kyma-un/srv_delorian/delorian_ws/src/delorian_description/meshes/main_frame.stl

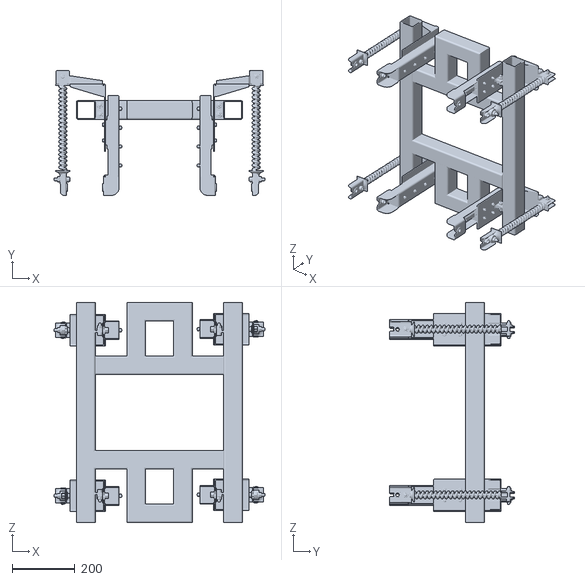
[picture p2: CAD file, 2026-10-21]
delorian_ws/src/delorian_description/meshes/main_frame.stl
670.1 x 396.6 x 700.0
