kyma-un/srv_delorian/delorian_ws/src/delorian_description/meshes/wheel.stl

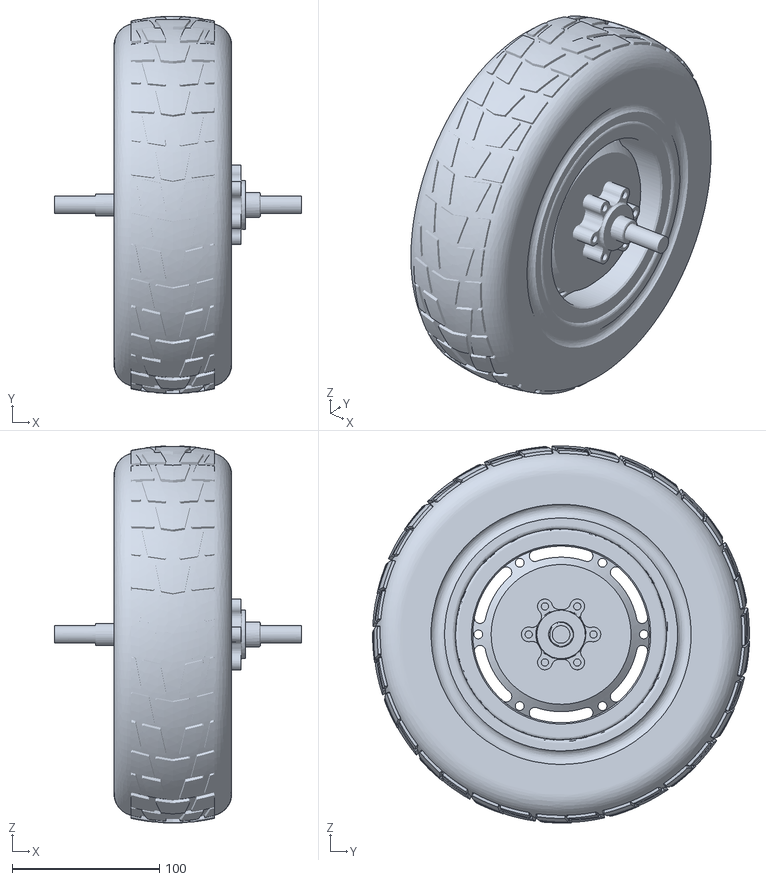
[picture p3: CAD file, 2026-10-21]
delorian_ws/src/delorian_description/meshes/wheel.stl
168.0 x 256.4 x 256.3
