kyma-un/srv_delorian/Diseño_mecanico/Frame_principal.stp

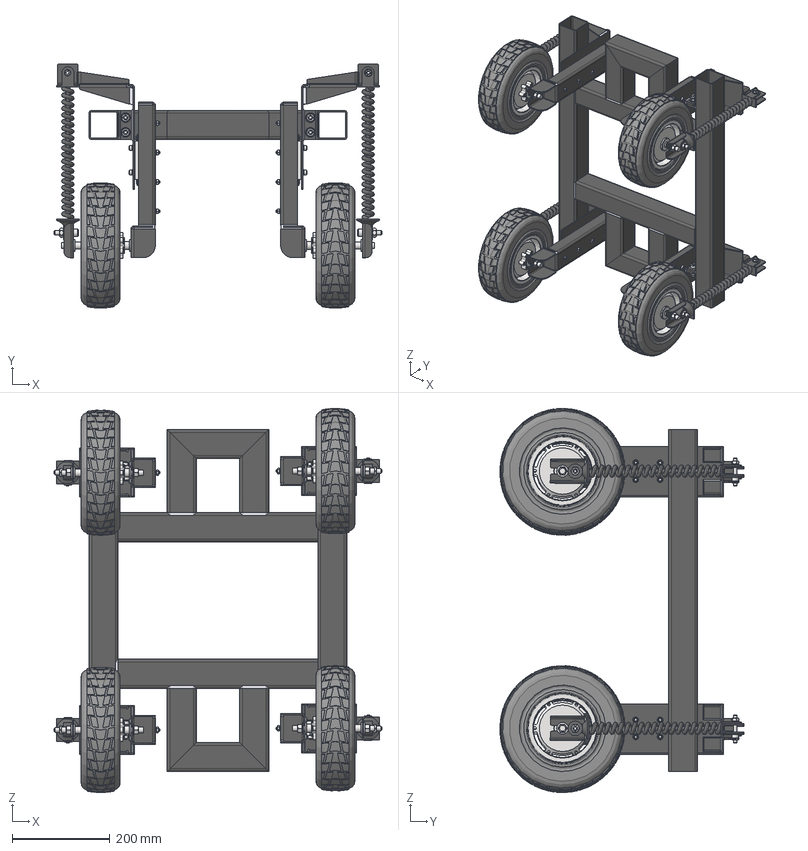
[picture p4: CAD file, 2026-10-02]
Diseño_mecanico/Frame_principal.stp
670.0 x 499.6 x 785.2 mm
Chasis_arm_1
Perfil_700 x 2
Perfil_416 x 2
Perfil_170_corte x 4
Perfil_96_corte x 2
Pernado x 4
Hub_correguido x 4
Neumatico x 4
L_fabricable_1 x 4
L_sheet x 4
Momento x 4
Pernado_1 x 4
Lineal_fabricable_1 x 4
Metal x 4
hgh25ha_01 x 4
hgh25ha_02 x 4
6_Tornillo x 16
6_Arandela x 32
6_Tuerca x 16
Tornillo x 4
Tuerca x 12
8_washer x 4
8_Tornillo x 4
8_Nut x 4
6_Tornillo_20 x 16
12_Nut x 8
12_Washer x 16
platina x 4
Amortiguador x 4
10_Tornillo_30 x 8
10_Arandela x 8
