kyma-un/srv_delorian/(list of files, cad)

Other CAD files:
Diseño_mecanico/Chasis/Plano.dwg
