kyma-un/srv_delorian/Diseño_mecanico/Chasis/Chasis.pdf

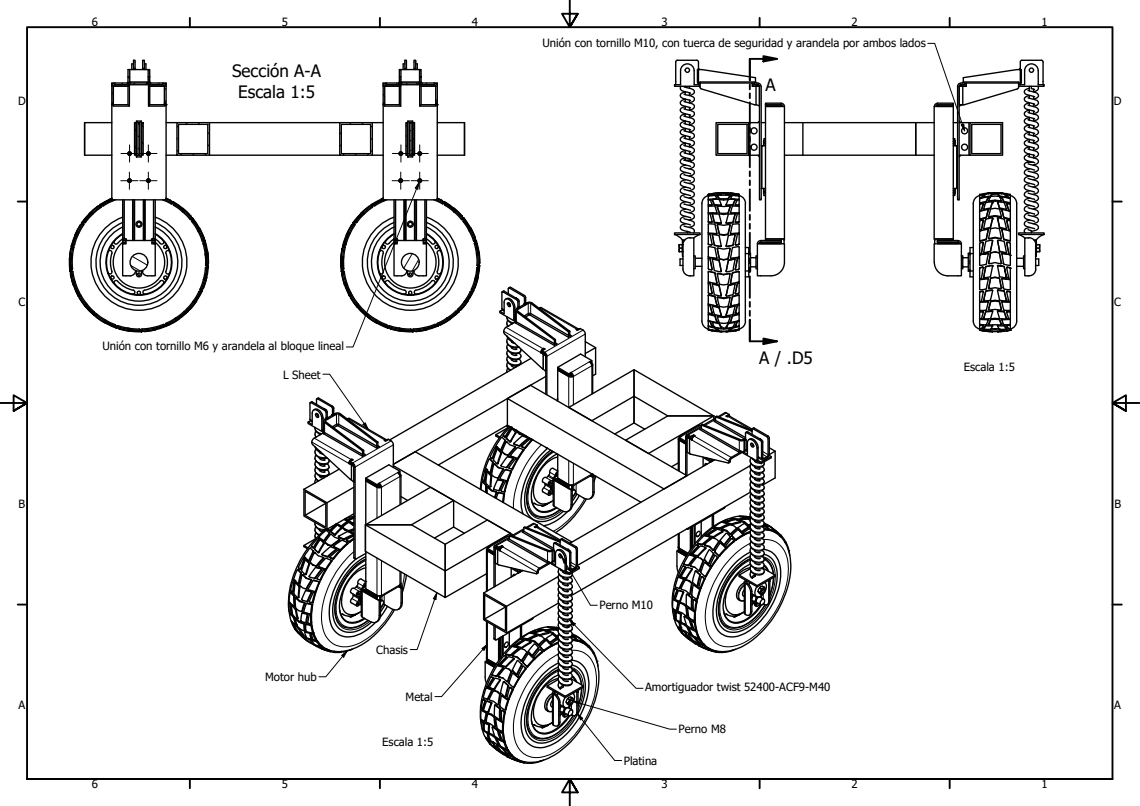
[picture p5: page 1]
Sección A-A Escala 1:5; L Sheet; Amortiguador twist 52400-ACF9-M40; Motor hub; Perno M10; Perno M8; Escala 1:5

Unión con tornillo M10, con tuerca de seguridad y arandela por ambos lados

Unión con tornillo M6 y arandela al bloque lineal
