kyma-un/srv_delorian/Diseño_mecanico/Chasis/Plano_chasis.pdf

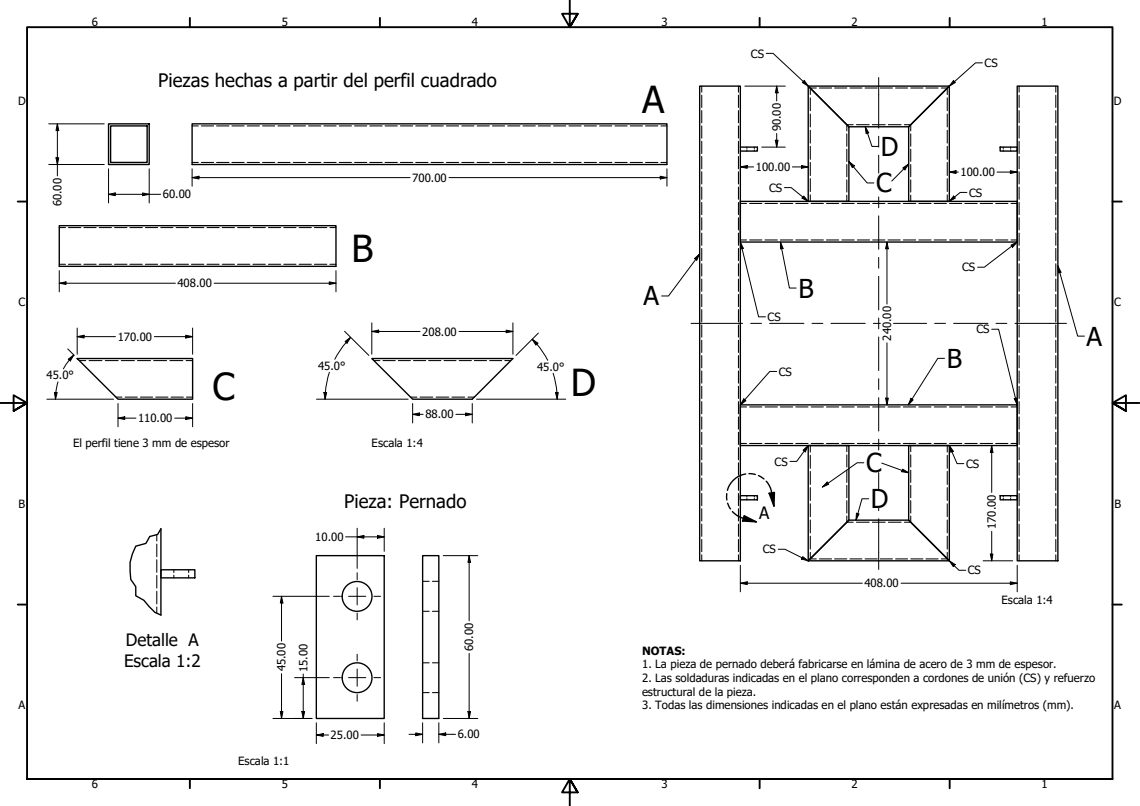
[picture p6: page 1]
Detalle A Escala 1:2; El perfil tiene 3 mm de espesor; Escala 1:4; Pieza: Pernado; Escala 1:1

Piezas hechas a partir del perfil cuadrado

NOTAS:
1. La pieza de pernado deberá fabricarse en lámina de acero de 3 mm de espesor.
2. Las soldaduras indicadas en el plano corresponden a cordones de unión (CS) y refuerzo
estructural de la pieza.
3. Todas las dimensiones indicadas en el plano están expresadas en milímetros (mm).
