kyma-un/srv_delorian/Diseño_mecanico/Suspension/Ensamble_riel/Ensamble_riel.pdf

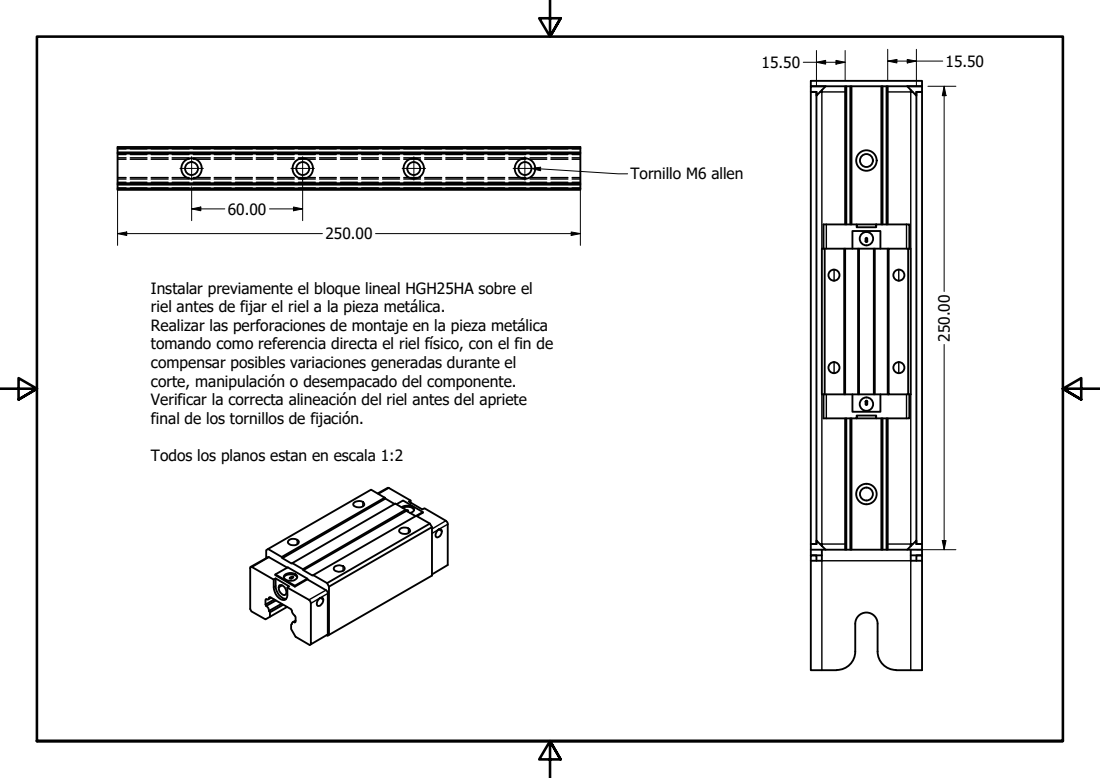
[picture p7: page 1]
Tornillo M6 allen

Instalar previamente el bloque lineal HGH25HA sobre el
riel antes de fijar el riel a la pieza metálica.
Realizar las perforaciones de montaje en la pieza metálica
tomando como referencia directa el riel físico, con el fin de
compensar posibles variaciones generadas durante el
corte, manipulación o desempacado del componente.
Verificar la correcta alineación del riel antes del apriete
final de los tornillos de fijación.

Todos los planos estan en escala 1:2
