kyma-un/srv_delorian/Diseño_mecanico/Suspension/Pieza acople al amortiguador/platina.pdf

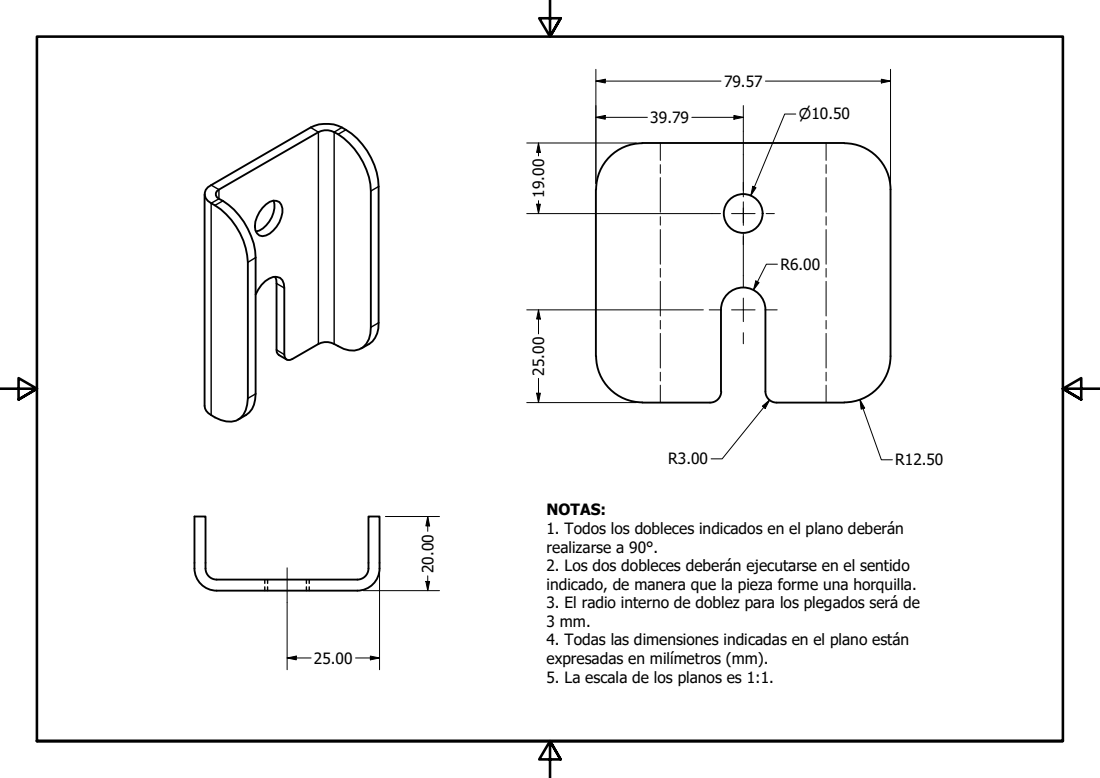
[picture p8: page 1]

NOTAS:
1. Todos los dobleces indicados en el plano deberán
realizarse a 90°.
2. Los dos dobleces deberán ejecutarse en el sentido
indicado, de manera que la pieza forme una horquilla.
3. El radio interno de doblez para los plegados será de
4. Todas las dimensiones indicadas en el plano están
expresadas en milímetros (mm).
5. La escala de los planos es 1:1.
