kyma-un/srv_delorian/Diseño_mecanico/Suspension/Pieza en L Soldada/L_sheet.pdf

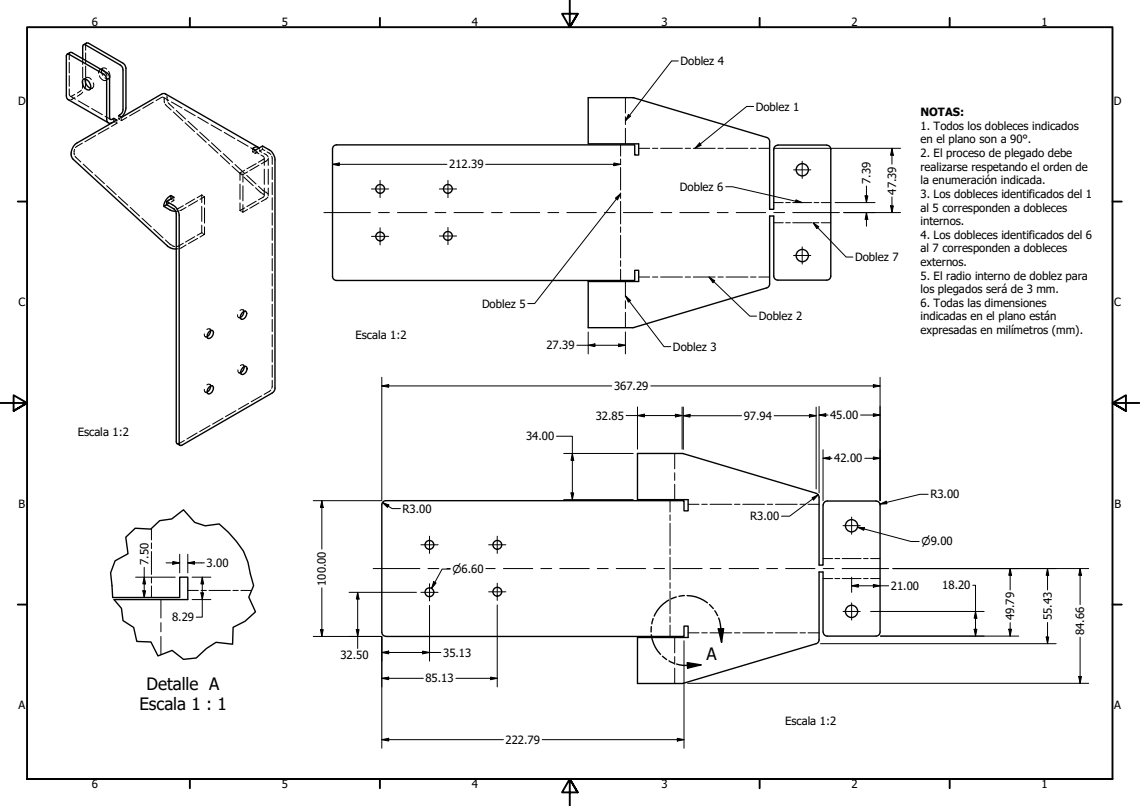
[picture p9: page 1]
Detalle A Escala 1 : 1; Doblez 1; Doblez 2; Doblez 3; Doblez 4; Doblez 5; Doblez 6; Doblez 7; Escala 1:2

NOTAS:
1. Todos los dobleces indicados
en el plano son a 90°.
2. El proceso de plegado debe
realizarse respetando el orden de
la enumeración indicada.
3. Los dobleces identificados del 1
al 5 corresponden a dobleces
internos.
4. Los dobleces identificados del 6
al 7 corresponden a dobleces
externos.
5. El radio interno de doblez para
los plegados será de 3 mm.
6. Todas las dimensiones
indicadas en el plano están
expresadas en milímetros (mm).
