kyma-un/srv_delorian/Diseño_mecanico/Suspension/Pieza en L Soldada/Montaje_de_la_L.pdf

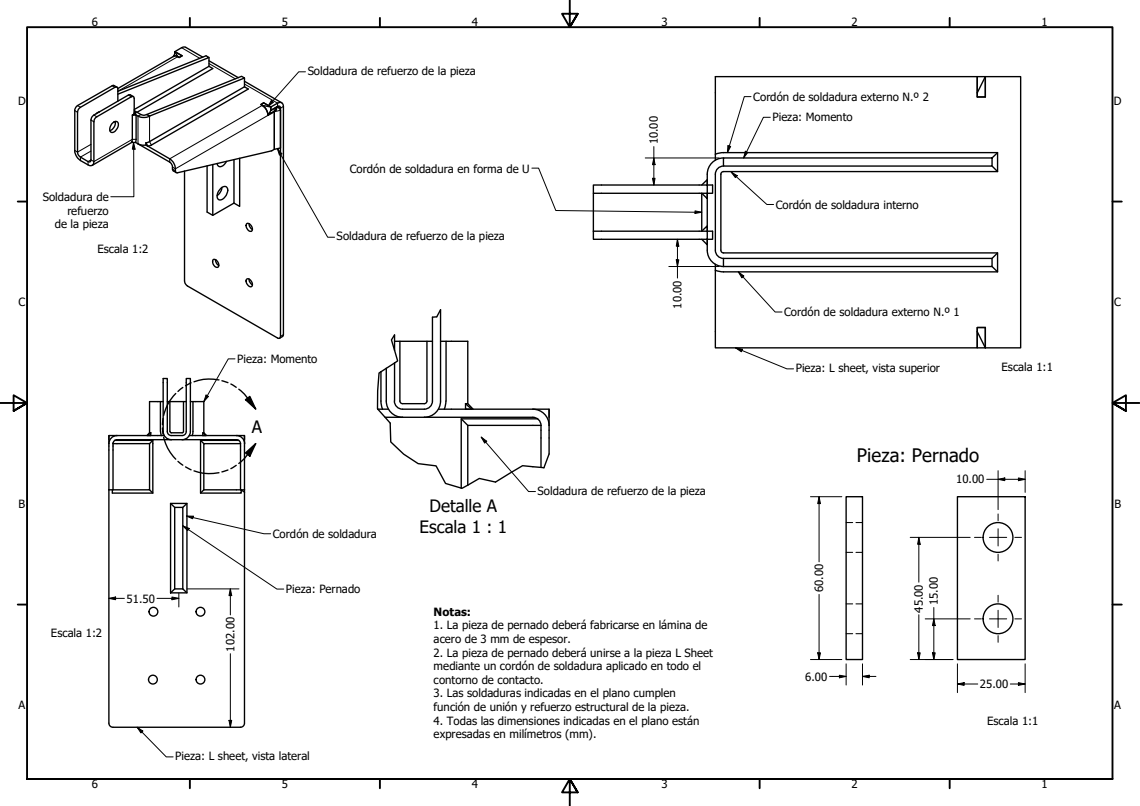
[picture p10: page 1]
Detalle A Escala 1 : 1; Pieza: Pernado; Pieza: Momento; Escala 1:1; Escala 1:2

Soldadura de refuerzo de la pieza

Cordón de soldadura externo N.º 2
Pieza: Momento

Cordón de soldadura en forma de U

Soldadura de
refuerzo
de la pieza

Cordón de soldadura interno

Cordón de soldadura externo N.º 1

Pieza: L sheet, vista superior

Cordón de soldadura

Notas:
1. La pieza de pernado deberá fabricarse en lámina de
acero de 3 mm de espesor.
2. La pieza de pernado deberá unirse a la pieza L Sheet
mediante un cordón de soldadura aplicado en todo el
contorno de contacto.
3. Las soldaduras indicadas en el plano cumplen
función de unión y refuerzo estructural de la pieza.
4. Todas las dimensiones indicadas en el plano están
expresadas en milímetros (mm).

Pieza: L sheet, vista lateral
