kyma-un/srv_delorian/Diseño_mecanico/Suspension/Ensamble_riel/Pieza lineal/Metal.pdf

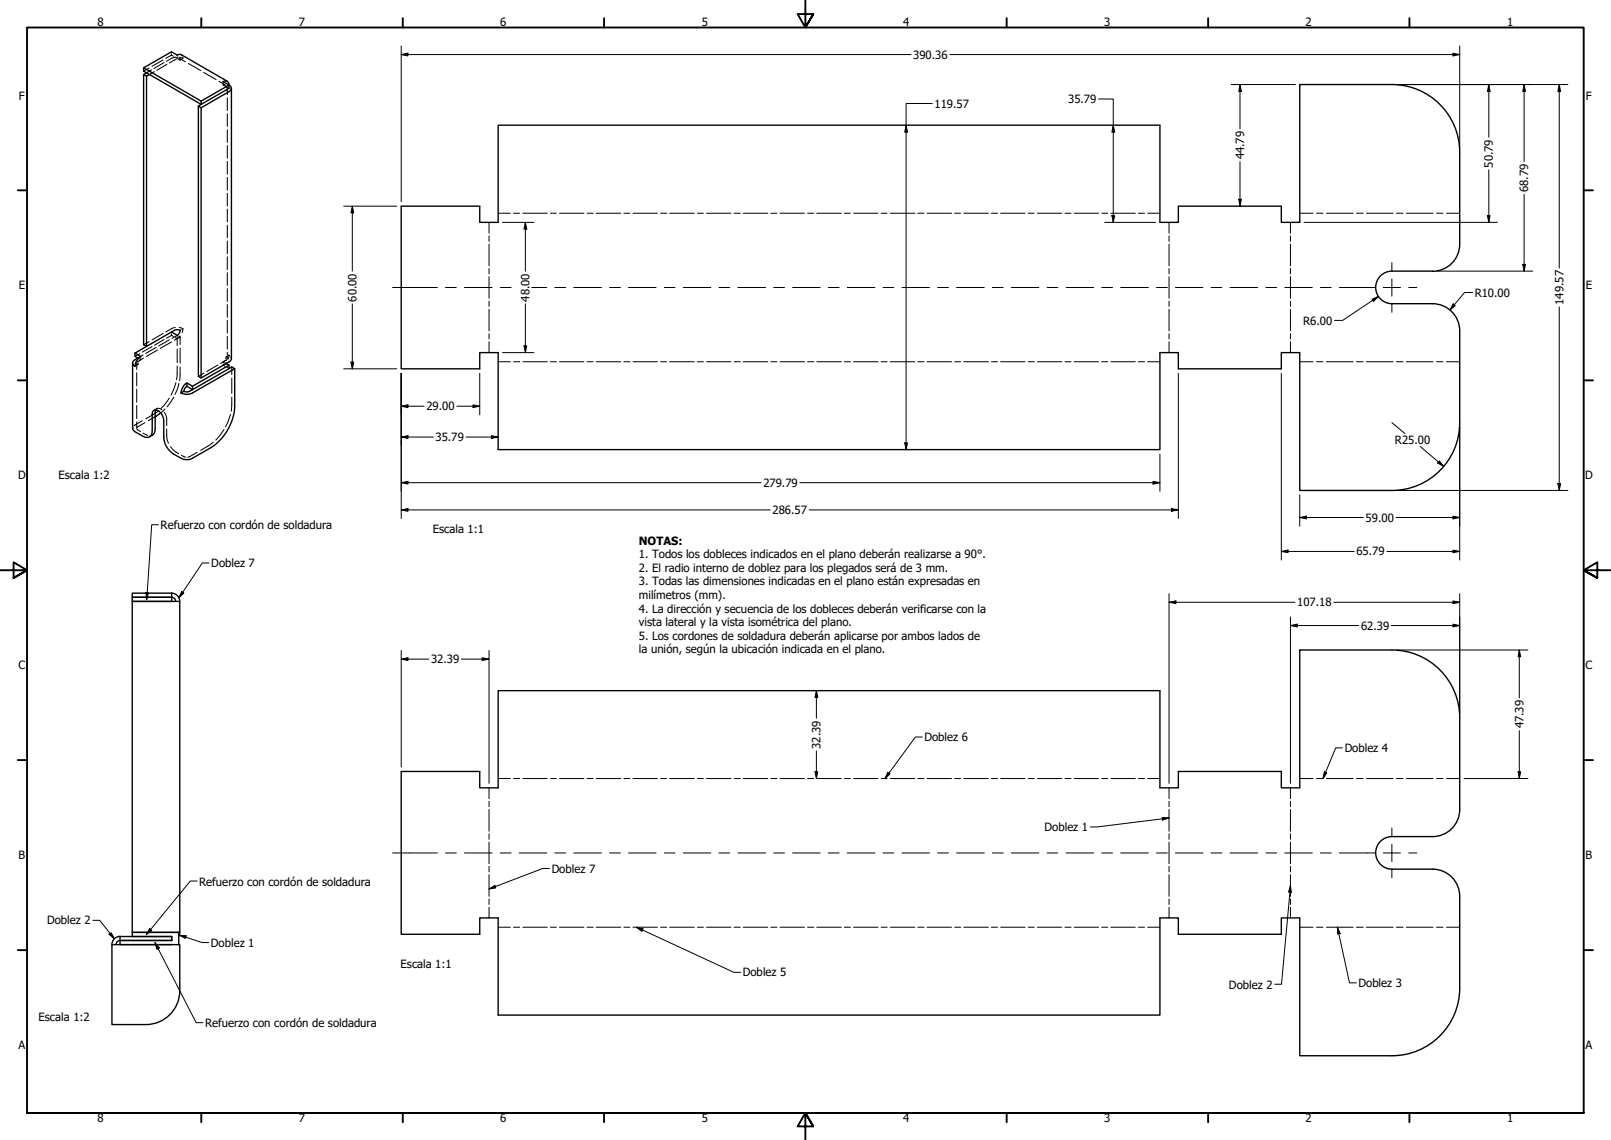
[picture p11: page 1]
Doblez 1; Doblez 2; Doblez; Doblez 4; Doblez 5; Doblez 6; Doblez 7; Escala 1:2; Escala 1:1

Refuerzo con cordón de soldadura

NOTAS:
1. Todos los dobleces indicados en el plano deberán realizarse a 90°.
2. El radio interno de doblez para los plegados será de 3 mm.
3. Todas las dimensiones indicadas en el plano están expresadas en
milímetros (mm).
4. La dirección y secuencia de los dobleces deberán verificarse con la
vista lateral y la vista isométrica del plano.
5. Los cordones de soldadura deberán aplicarse por ambos lados de
la unión, según la ubicación indicada en el plano.
