kyma-un/srv_delorian/(commit log)

2026-09-30 Mini-actualizacion-readme, y cambio de nombre del repo, srv-ram->srv_delorian
2026-10-21 cambios urdf gz y base, incluir oak
2026-10-26 cambios sdf world y odometria
2026-10-26 solve issue gz ip, error de multicast para servidor gazebo servidor y ventana resuelto
2026-10-27 add imu and gps in gazebo and urdf core
